pj-hoakari/esp-edge-device/docs/camera-349c-3307.md

# HD video (349C:3307) 調査記録

2026-10-31、接続中のUSBカメラをWindows PnPとUSBハブIOCTLで読み取り確認した。
メーカー・販売型番は未特定。VID/PIDだけから製造元やセンサーを推測していない。

- VID:PID = **349C:3307**
- Windows映像デバイス名：`HD video`、音声：`HD audio`（本ファームウェアでは音声は使用しない）
- PCでの現在の接続速度：**USB Full Speed**（USB_NODE_CONNECTION_INFORMATION_EX.Speed = 1）
- UVC映像形式：MJPEG。以下はdescriptorの申告値であり、実測fpsではない。

| 解像度 | 広告されるfps | 既定fps | frame descriptorの最大bytes |
| --- | --- | --- | --- |
| 1280×720 | 15 / 10 | 15 | 1,843,200 |
| 800×480 | 20 / 15 | 20 | 768,000 |
| 640×480 | 25 / 15 | 25 | 614,400 |
| 480×320 | 25 / 15 | 25 | 307,200 |

720pのframe intervalは666,666 / 1,000,000（100ns単位）。**2fpsは広告されていない**。
ファームウェアは解像度を1280×720（HD）固定とし、低解像度へ落とす設定は持たない。
既定値は720p MJPEG・10fps受信、送信目標6fps、静止時Idle 2fps。
撮影fpsを送信側の間引きで落としても、USB上の受信帯域は減らない。
例えば50KiB/枚×10fpsなら約512kB/sであり、
USBホスト・Wi-Fi・DTLS/SCTP同時処理での成立は実機で確かめる。

descriptorの最大フレーム値は幅×高さ×2に相当するが、実際のJPEGサイズとして扱わない。
ファームウェアは1枚256KiBを上限にし、超過フレームを破棄する。
映像のカラー、破損の有無、実際のフレームサイズ、ESP32-S3でのUVC negotiation、
実測fpsと長時間動作は未確認。今回PCの映像は取得していない。

other-speed configurationの照会は取得できなかった。今回のFull Speedの判定は
現在の接続速度そのものから行っており、この取得失敗から別速度への対応可否は判断しない。

再現用スクリプト：`esp_webcam/tools/probe_windows_camera.py`。
USBハブに対しGET_NODE_INFORMATION、GET_NODE_CONNECTION_INFORMATION_EX、GET_DESCRIPTORのみを使用する。
ドライバの置換、撮影、切断・再接続、電源操作は行わない。

API根拠：Microsoftの
[接続情報構造体](https://learn.microsoft.com/en-us/windows-hardware/drivers/ddi/usbioctl/ns-usbioctl-_usb_node_connection_information_ex)、
[descriptor取得IOCTL](https://learn.microsoft.com/en-us/windows-hardware/drivers/ddi/usbioctl/ni-usbioctl-ioctl_usb_get_descriptor_from_node_connection)、
[USB_DESCRIPTOR_REQUEST](https://learn.microsoft.com/en-us/windows-hardware/drivers/ddi/usbioctl/ns-usbioctl-_usb_descriptor_request)を2026-10-31参照。
