pj-hoakari/esp-edge-device/exports/BOM_JLCPCB.csv

Comment | Designator | Footprint | LCSC Part # | Manufacturer | MPN | Quantity
2.2uF | C1 | C_0603_1608Metric | C23630 | Samsung Electro-Mechanics | CL10A225KO8NNNC | 1
100nF | C2 | C_0603_1608Metric | C1591 | Samsung Electro-Mechanics | CL10B104KB8NNNC | 1
1uF | C3 | C_0603_1608Metric | C15849 | Samsung Electro-Mechanics | CL10A105KB8NNNC | 1
22uF | C4 | C_0805_2012Metric | C45783 | Samsung Electro-Mechanics | CL21A226MAQNNNE | 1
10k | R1 | R_0603_1608Metric | C25804 | UNI-ROYAL | 0603WAF1002T5E | 1
5.1k | R2,R3 | R_0603_1608Metric | C23186 | UNI-ROYAL | 0603WAF5101T5E | 2
USB1046-GF-0190-L-B-A | J1 | USB_A_Receptacle_GCT_USB1046 | C6307429 | Global Connector Technology | USB1046-GF-0190-L-B-A | 1
TYPE-C-31-M-12 | J2 | USB_C_Receptacle_HRO_TYPE-C-31-M-12 | C165948 | Korean Hroparts Elec | TYPE-C-31-M-12 | 1
ESP32-S3-WROOM-1-N8R8 | U1 | ESP32-S3-WROOM-1 | C2913201 | Espressif Systems | ESP32-S3-WROOM-1-N8R8 | 1
AZ1117CH-3.3TRG1 | U2 | SOT-223-3_TabPin2 | C92102 | Diodes Incorporated | AZ1117CH-3.3TRG1 | 1
