pj-hoakari/esp-edge-device/esp_webcam.kicad_pcb

## KiCad design esp_webcam.kicad_pcb (2026-10-31)

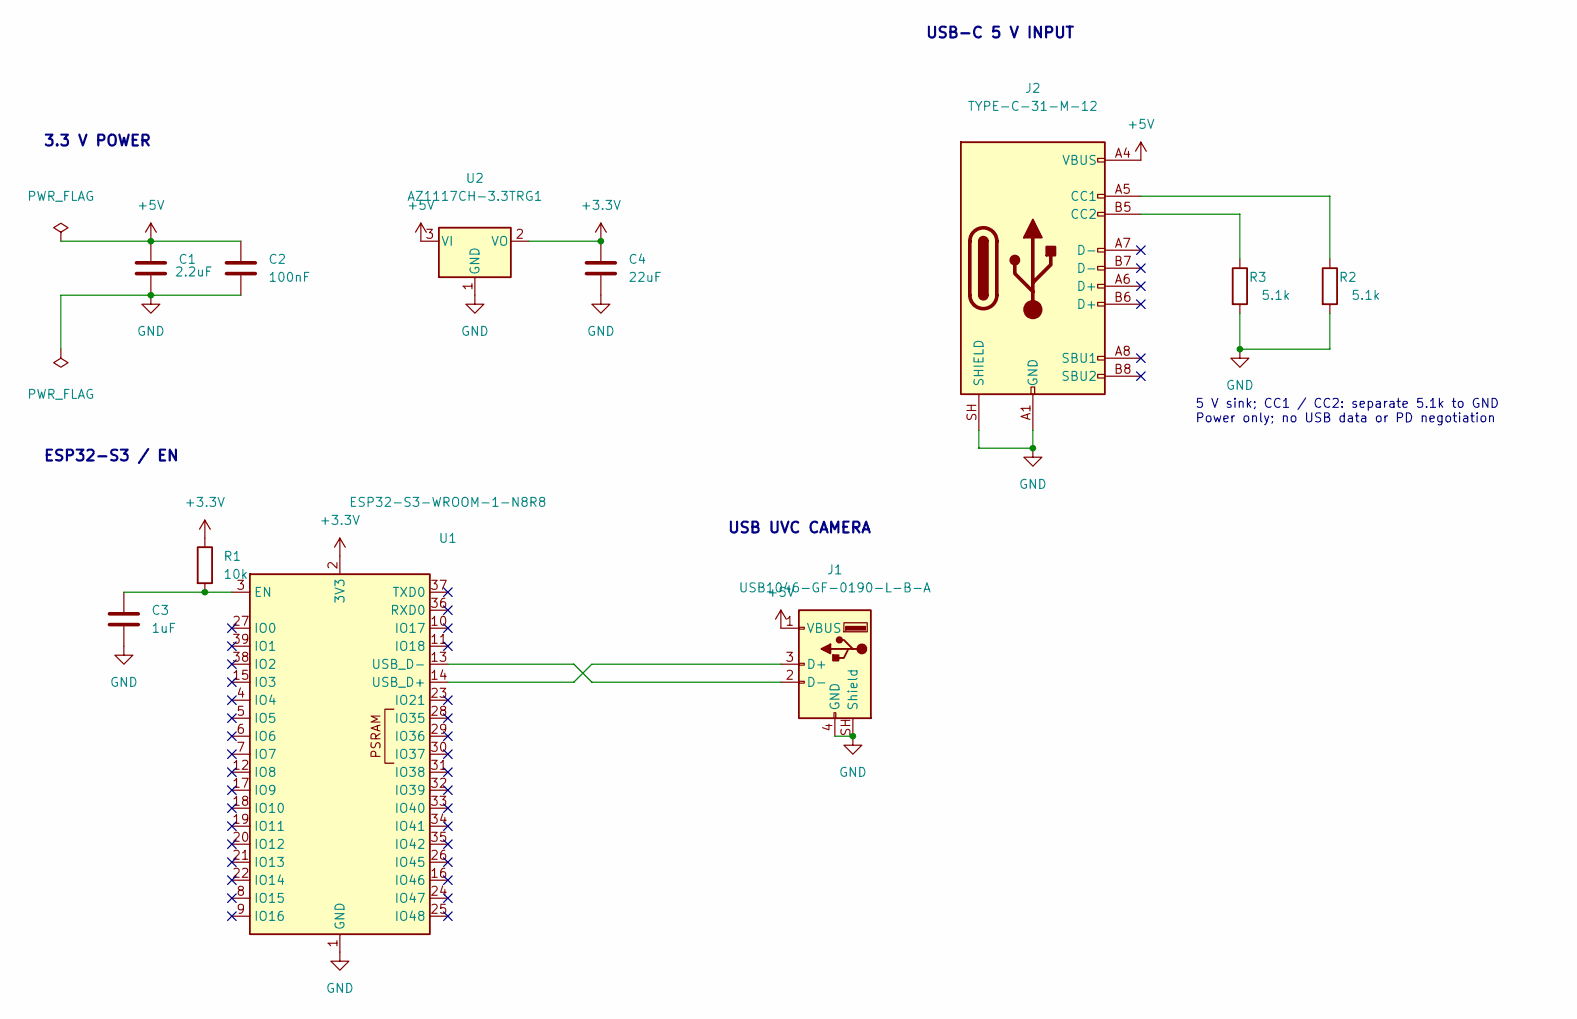
[picture p1: schematic esp_webcam.kicad_sch]

Parts:
C1: 2.2uF; C_0603_1608Metric; Voltage 16V; Tolerance 10%; MPN CL10A225KO8NNNC; LCSC C23630
C2: 100nF; C_0603_1608Metric; Voltage 50V; Tolerance 10%; MPN CL10B104KB8NNNC; LCSC C1591
C3: 1uF; C_0603_1608Metric; Voltage 50V; Tolerance 10%; MPN CL10A105KB8NNNC; LCSC C15849
C4: 22uF; C_0805_2012Metric; Voltage 25V; Tolerance 20%; MPN CL21A226MAQNNNE; LCSC C45783
J1: USB1046-GF-0190-L-B-A; USB_A_Receptacle_GCT_USB1046; MPN USB1046-GF-0190-L-B-A; LCSC C6307429
J2: TYPE-C-31-M-12; USB_C_Receptacle_HRO_TYPE-C-31-M-12; MPN TYPE-C-31-M-12; LCSC C165948
R1: 10k; R_0603_1608Metric; Tolerance 1%; MPN 0603WAF1002T5E; LCSC C25804
R2, R3: 5.1k; R_0603_1608Metric; Tolerance 1%; MPN 0603WAF5101T5E; LCSC C23186
U1: ESP32-S3-WROOM-1-N8R8; ESP32-S3-WROOM-1; MPN ESP32-S3-WROOM-1-N8R8; LCSC C2913201
U2: AZ1117CH-3.3TRG1; SOT-223-3_TabPin2; MPN AZ1117CH-3.3TRG1; LCSC C92102

Connections:
+3.3V: C4.1, R1.1, U1.2 (3V3), U2.2 (VO)
+5V: C1.1, C2.1, J1.1 (VBUS), J2.A4 (VBUS), J2.A9 (VBUS), J2.B4 (VBUS), J2.B9 (VBUS), U2.3 (VI)
GND: C1.2, C2.2, C3.2, C4.2, J1.4 (GND), J1.SH (Shield), J2.A1 (GND), J2.A12 (GND), J2.B1 (GND), J2.B12 (GND), J2.SH (SHIELD), R2.2, R3.2, U1.1 (GND), U1.40 (GND), U1.41 (GND), U2.1 (GND)
unnamed: J1.3 (D+), U1.14 (USB_D+)
unnamed: J1.2 (D-), U1.13 (USB_D-)
unnamed: J2.A5 (CC1), R2.1
unnamed: J2.B5 (CC2), R3.1
unnamed: C3.1, R1.2, U1.3 (EN)

Notes on the sheet:
ESP32-S3 / EN
3.3 V POWER
USB UVC CAMERA
5 V sink; CC1 / CC2: separate 5.1k to GND Power only; no USB data or PD negotiation
USB-C 5 V INPUT

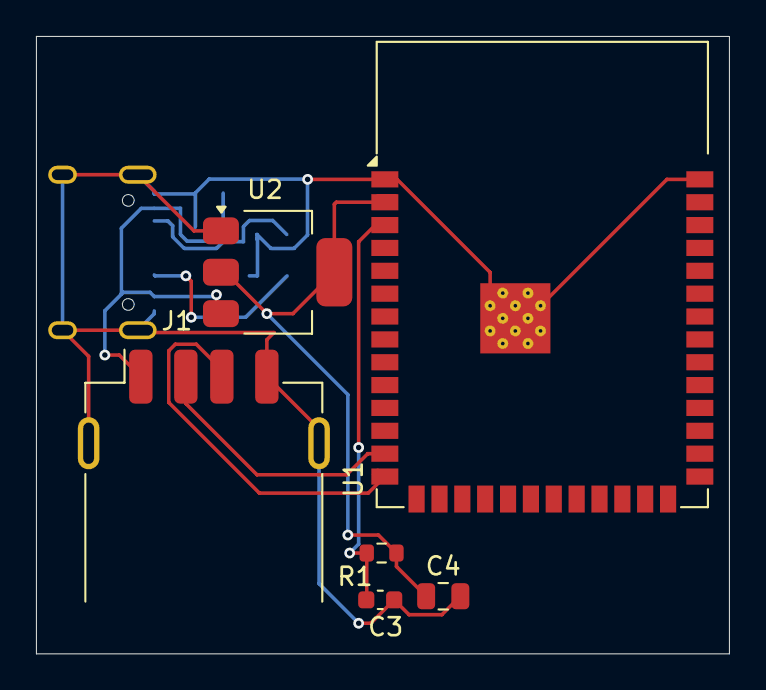
[picture p2: board esp_webcam.kicad_pcb from above]

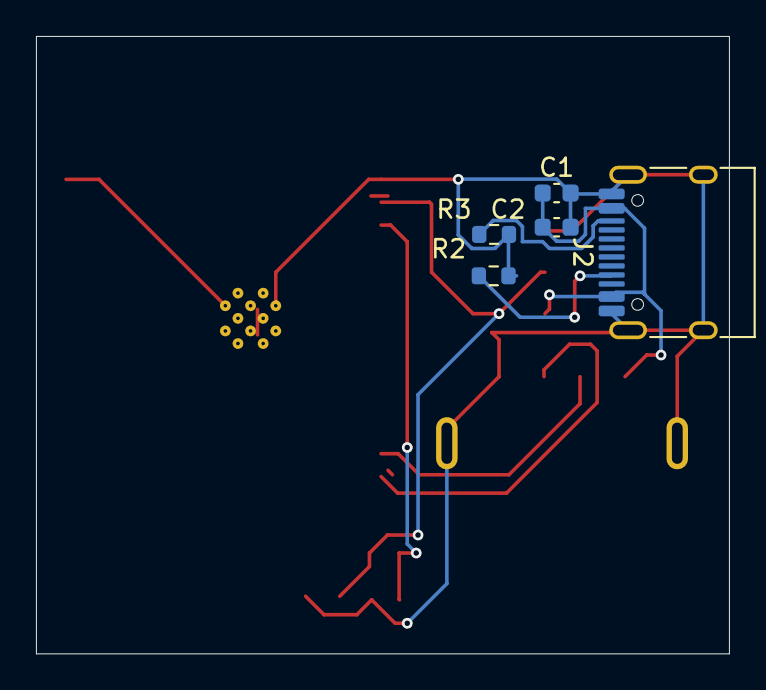
[picture p3: board esp_webcam.kicad_pcb from below]

Board: 2 copper layers, 38.5 x 34.3 mm, 11 parts (5 on the bottom side), 8 nets.
