pj-hoakari/esp-edge-device/esp_webcam/main/webrtc.h

#pragma once
#include <stdbool.h>
#include <stddef.h>
void webrtc_start(void);
bool webrtc_video_active(void);
/* Cloud signaling hands a discovered console offer to the peer task. */
bool webrtc_submit_offer(const char *sdp, const char *session_id);
/* Takes the peer's answer after a short settle delay. *sdp is malloc'd. */
bool webrtc_take_answer(char **sdp, char *session_id, size_t size);
int webrtc_status_json(char *out, size_t size);
/* Changes apply to new handshakes for cipher, immediately for burst settings. */
bool webrtc_configure(int cipher, unsigned chunks, unsigned burst_us, bool fast_rx);
bool webrtc_fast_rx(void);
bool webrtc_save_tuning(void);
