pj-hoakari/esp-edge-device/(commit log)

2026-10-31 Initial commit: KiCad design and ESP32-S3 UVC webcam firmware
    [BOM_JLCPCB.csv, esp_webcam.kicad_pcb, esp_webcam.kicad_sch]
2026-10-31 Add Node signaling viewer and fix DataChannel video delivery
    [main.c, mjpeg_main.c, webrtc.h]
2026-11-01 Increase WebRTC frame throughput and remove static-scene throttling
2026-11-02 Add network console, enterprise Wi-Fi, and HTTPS signaling
    - configure Wi-Fi, EAP, and signaling from the UART console and persist to NVS
    - validate HTTPS signaling with the ESP-IDF CA bundle and cross-signed roots
    - stop offer polling while streaming and reconnect on SCTP close or 10 s ACK loss
    - add pin/STUN/signaling diagnostics, PC tests, and credential upload tooling
    - allow the browser benchmark to target a Cloudflare Tunnel viewer URL
2026-11-02 tolo-webと接続できるように
2026-11-02 依存を修正
2026-11-03 feat(esp): add device authorization and machine-readable provisioning
2026-11-03 feat(esp): encrypt NVS with a dedicated key partition
    [partitions.csv]
2026-11-03 fix(esp): reissue Firebase tokens after event access rotation
    [cloud_auth_logic.c, cloud_auth_logic.h, cloud_signaling.c]
2026-11-03 fix(esp): raise the cloud task stack for device authorization
    [cloud_signaling.c]
2026-11-04 fix(esp): move authorization off the console and require TLS
    Queue authorization starts on the cloud task, stop streaming and close peers when authorization is revoked, and reject credential-bearing HTTP endpoints unless the development flag is enabled.
    [cloud_settings.c, cloud_settings.h, cloud_settings_values.c, cloud_settings_values.h, cloud_signaling.c, credential_transport.h]
2026-11-04 fix(esp): harden refresh backoff and NVS provisioning
    Respect refresh retry backoff, preserve credentials across configuration saves, reject expired event access, add a best-effort cross-namespace save rollback, and provide an eFuse-HMAC fail-closed secure build profile.
    [cloud_settings.c, cloud_settings.h, device_auth.c, network_settings.c, network_settings.h, nvs_boot.c]
2026-11-07 chore(deps): pin espressif/idf docker tag to ba5c7e9
